Eelviny/wardrobe-controller/wardrobe-controller.kicad_pcb

## KiCad design wardrobe-controller.kicad_pcb (2026-01-08)

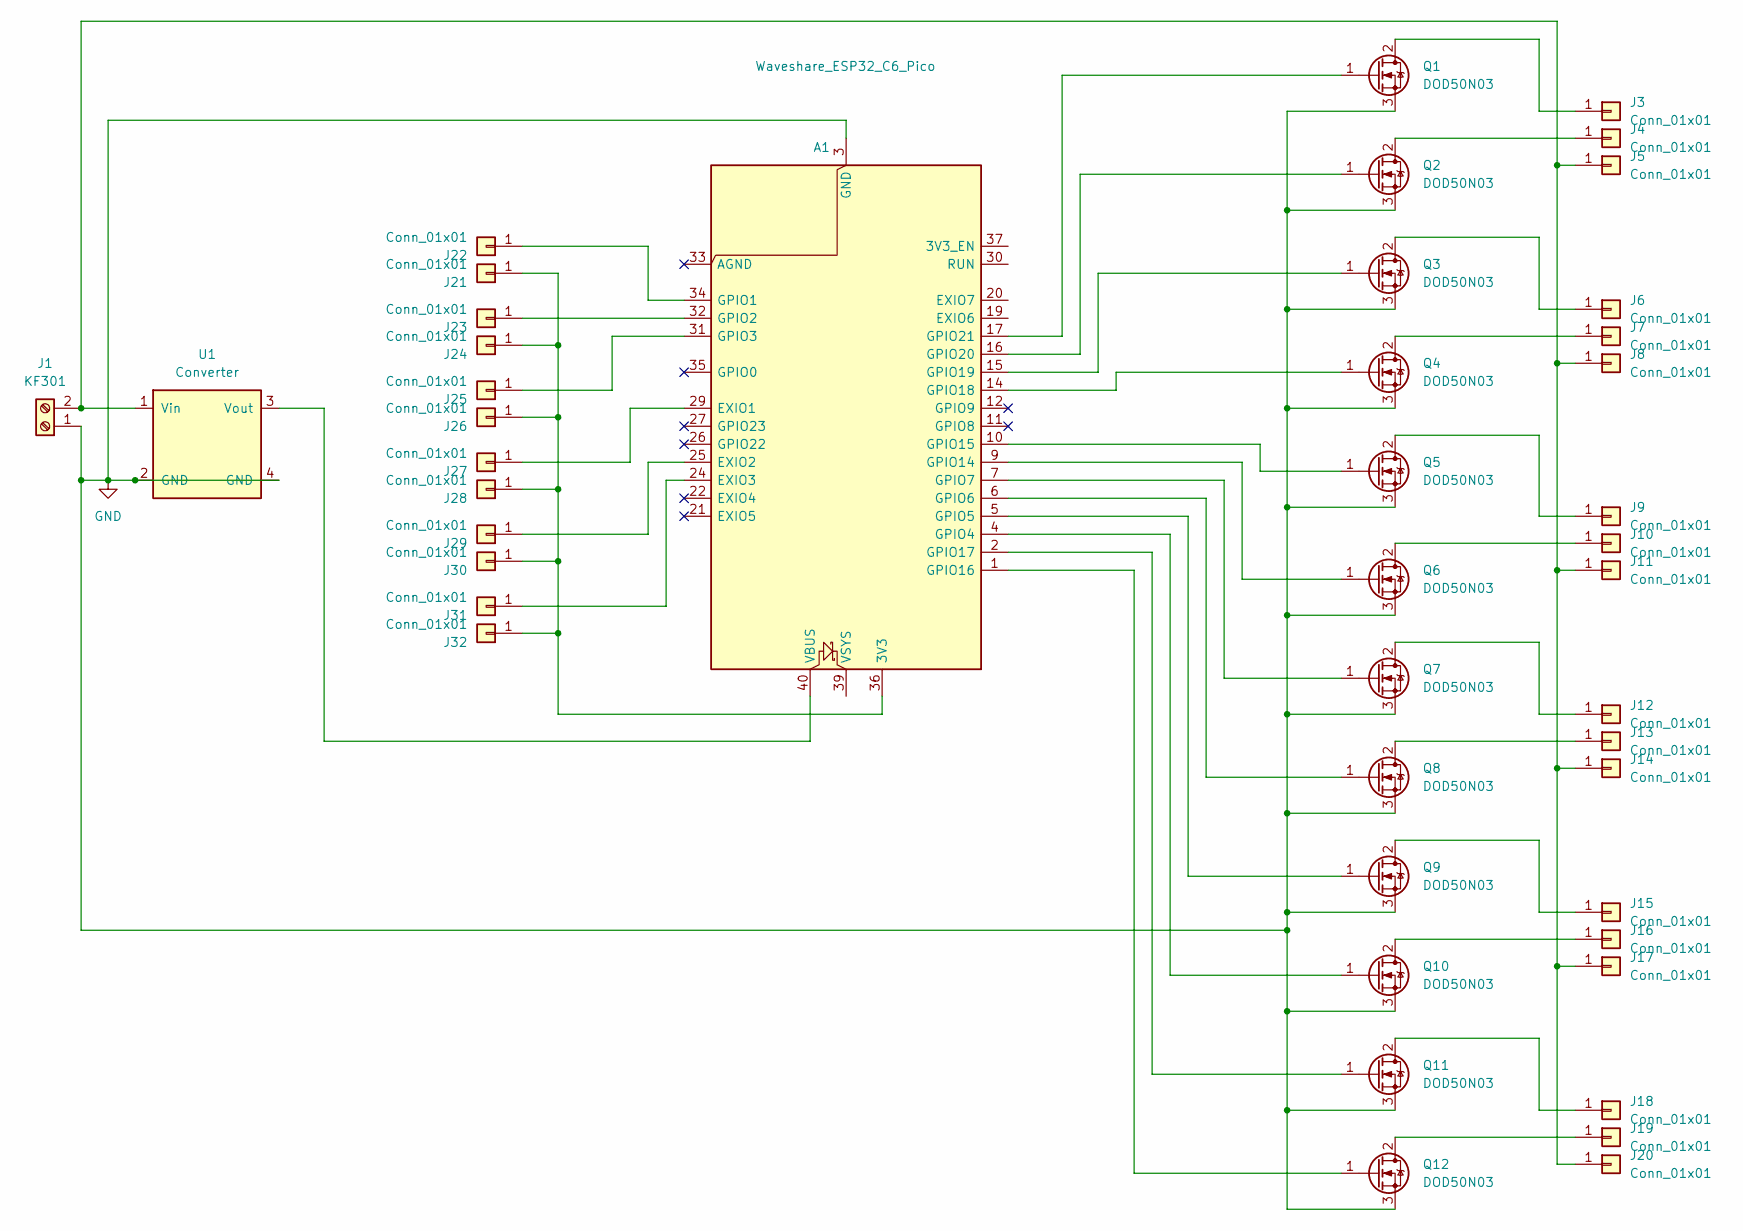
[picture p1: schematic wardrobe-controller.kicad_sch]

Parts:
A1: Waveshare_ESP32_C6_Pico; RaspberryPi_Pico_Common
J1: KF301; TerminalBlock_RND_205-00012_1x02_P5.00mm_Horizontal; JLCPCB_IGNORE yes
J3, J4, J5, J6, J7, J8, J9, J10, J11, J12, J13, J14, J15, J16, J17, J18, J19, J20, J21, J22, J23, J24, J25, J26, J27, J28, J29, J30, J31, J32: Conn_01x01; SolderPad; JLCPCB_IGNORE yes
Q1, Q2, Q3, Q4, Q5, Q6, Q7, Q8, Q9, Q10, Q11, Q12: DOD50N03; TO-252-2; LCSC C36499176
U1: Converter; Buck_Converter_Module

Connections:
GND: A1.3 (GND), A1.8 (GND), A1.13 (GND), A1.18 (GND), A1.23 (GND), A1.28 (GND), A1.38 (GND), J1.1, Q1.3 (S), Q2.3 (S), Q3.3 (S), Q4.3 (S), Q5.3 (S), Q6.3 (S), Q7.3 (S), Q8.3 (S), Q9.3 (S), Q10.3 (S), Q11.3 (S), Q12.3 (S), U1.2 (GND), U1.4 (GND)
unnamed: A1.36 (3V3), J21.1, J24.1, J26.1, J28.1, J30.1, J32.1
unnamed: A1.29 (EXIO1), J27.1
unnamed: A1.25 (EXIO2), J29.1
unnamed: A1.24 (EXIO3), J31.1
unnamed: A1.34 (GPIO1), J22.1
unnamed: A1.32 (GPIO2), J23.1
unnamed: A1.31 (GPIO3), J25.1
unnamed: A1.4 (GPIO4), Q10.1 (G)
unnamed: A1.5 (GPIO5), Q9.1 (G)
unnamed: A1.6 (GPIO6), Q8.1 (G)
unnamed: A1.7 (GPIO7), Q7.1 (G)
unnamed: A1.9 (GPIO14), Q6.1 (G)
unnamed: A1.10 (GPIO15), Q5.1 (G)
unnamed: A1.1 (GPIO16), Q12.1 (G)
unnamed: A1.2 (GPIO17), Q11.1 (G)
unnamed: A1.14 (GPIO18), Q4.1 (G)
unnamed: A1.15 (GPIO19), Q3.1 (G)
unnamed: A1.16 (GPIO20), Q2.1 (G)
unnamed: A1.17 (GPIO21), Q1.1 (G)
unnamed: A1.40 (VBUS), U1.3 (Vout)
unnamed: J1.2, J5.1, J8.1, J11.1, J14.1, J17.1, J20.1, U1.1 (Vin)
unnamed: J3.1, Q1.2 (D)
unnamed: J4.1, Q2.2 (D)
unnamed: J6.1, Q3.2 (D)
unnamed: J7.1, Q4.2 (D)
unnamed: J9.1, Q5.2 (D)
unnamed: J10.1, Q6.2 (D)
unnamed: J12.1, Q7.2 (D)
unnamed: J13.1, Q8.2 (D)
unnamed: J15.1, Q9.2 (D)
unnamed: J16.1, Q10.2 (D)
unnamed: J18.1, Q11.2 (D)
unnamed: J19.1, Q12.2 (D)

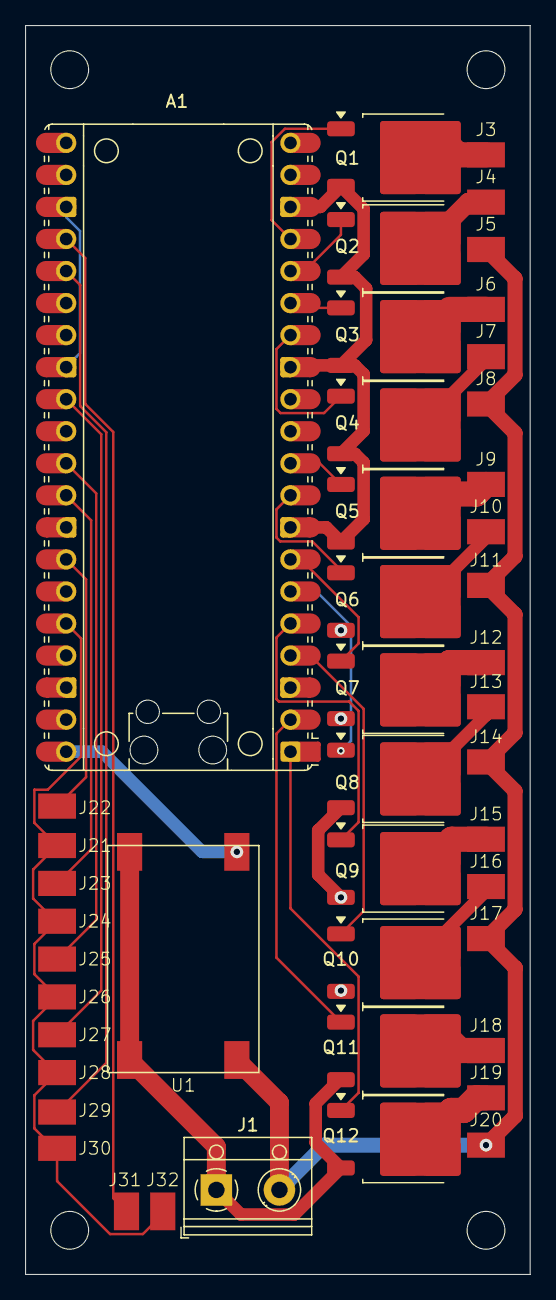
[picture p2: board wardrobe-controller.kicad_pcb from above]

Board: 2 copper layers, 40.0 x 99.0 mm, 45 parts (0 on the bottom side), 34 nets.
